rnyholm/iris/README.md

# Iris

Home for the simple marine auto pilot project Iris. This project should be seen as a fun, exploring, educational project. Involving anything from prototyping of electronics and coding to control engineering. 

### Goals

The goal with this project is to get a boat follow a given heading, this is done with a microcontroller taking input from a GPS(heading, ground speed, clock and so on), a rotary encoder for letting the user set the desired heading, a potentiometer joystick is used for letting the user override the autopilot. All the data is displayed on a 7 inch TFT screen. At last the microcontroller controls a linear servo attached to the rudder via a motorcontroller.  
A PID regulator is to be implemented on the microcontroller for calculating the controller ouput to the servo.
In short this is a kickass project with many interesting parts.

### Bits and pieces
[Arduino DUE](http://arduino.cc/en/Main/arduinoBoardDue)  
[Pololu JRK 12v12](http://www.pololu.com/product/1393)  
[Adafruit Ultimate GPS Breakout](http://www.adafruit.com/products/746)  
[LA-DW-12V 350N 250mm stroke](http://www.actuatorlinear.com/index.php?_m=mod_product&_a=view&p_id=238)  
[Rotary Encoder](https://www.sparkfun.com/products/10982)  
[7" color tft lcd with RA8875 controller board](http://www.buydisplay.com/default/7-inch-lcd-module-capacitive-touch-screen-panel-i2c-spi-serial)  
More is still to come...

### At last
Remember to support Open Source and Open Hardware communities!
