rnyholm/iris/src/iris/config/pololu_jrk_motor_controller.txt

INITIALIZED	0
INPUT_MODE	ANALOG
INPUT_MINIMUM	581
INPUT_MAXIMUM	2435
OUTPUT_MINIMUM	0
OUTPUT_NEUTRAL	2048
OUTPUT_MAXIMUM	4095
INPUT_INVERT	0
INPUT_SCALING_DEGREE	0
INPUT_POWER_WITH_AUX	0
INPUT_ANALOG_SAMPLES_EXPONENT	5
INPUT_DISCONNECT_MINIMUM	290
INPUT_DISCONNECT_MAXIMUM	3265
INPUT_NEUTRAL_MAXIMUM	1507
INPUT_NEUTRAL_MINIMUM	1507
SERIAL_MODE	USB_DUAL_PORT
SERIAL_FIXED_BAUD_RATE	9600
SERIAL_TIMEOUT	0
SERIAL_ENABLE_CRC	0
SERIAL_NEVER_SUSPEND	0
SERIAL_DEVICE_NUMBER	11
FEEDBACK_MODE	ANALOG
FEEDBACK_MINIMUM	1700
FEEDBACK_MAXIMUM	2330
FEEDBACK_INVERT	0
FEEDBACK_POWER_WITH_AUX	1
FEEDBACK_DEAD_ZONE	0
FEEDBACK_ANALOG_SAMPLES_EXPONENT	5
FEEDBACK_DISCONNECT_MINIMUM	1694
FEEDBACK_DISCONNECT_MAXIMUM	2336
PROPORTIONAL_MULTIPLIER	7
PROPORTIONAL_EXPONENT	0
INTEGRAL_MULTIPLIER	655
INTEGRAL_EXPONENT	10
DERIVATIVE_MULTIPLIER	1
DERIVATIVE_EXPONENT	0
PID_PERIOD	10
PID_INTEGRAL_LIMIT	1000
PID_RESET_INTEGRAL	0
MOTOR_PWM_FREQUENCY	0
MOTOR_INVERT	1
MOTOR_MAX_DUTY_CYCLE_WHILE_FEEDBACK_OUT_OF_RANGE	150
MOTOR_MAX_ACCELERATION_FORWARD	600
MOTOR_MAX_ACCELERATION_REVERSE	600
MOTOR_MAX_DUTY_CYCLE_FORWARD	150
MOTOR_MAX_DUTY_CYCLE_REVERSE	150
MOTOR_MAX_CURRENT_FORWARD	28
MOTOR_MAX_CURRENT_REVERSE	28
MOTOR_CURRENT_CALIBRATION_FORWARD	149
MOTOR_CURRENT_CALIBRATION_REVERSE	149
MOTOR_BRAKE_DURATION_FORWARD	0
MOTOR_BRAKE_DURATION_REVERSE	0
MOTOR_COAST_WHEN_OFF	0
ERROR_ENABLE	102
ERROR_LATCH	102
