rnyholm/iris/documentation/la_dw_specification.pdf

### Specification

MODEL | LA-DW
Input Voltage | 12VDC,24VDC,36VDC
Load capacity | 900N / 200Ibs
Stroke length | 1 inch- 12 inch/ 25mm- 300mm
Speed Range | 0.2 inch- 1.2 inch/sec / 5mm/ 30mm/sec
Duty Cycle | 25%
Operation Temperation | -25 °c - 65°c
Limit Switch | Factory Preset(not movable)
Potentiometer | 1Kom/ 5Kom/ 10Kom
IP grade | IP54, IP 65.

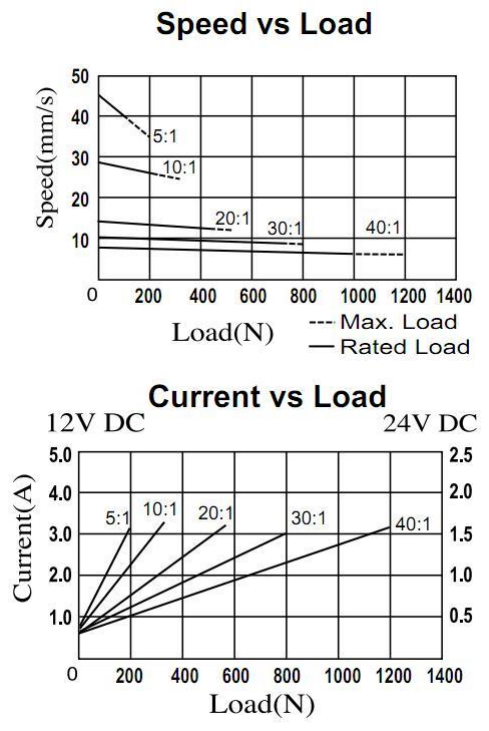
[picture p1: figure]

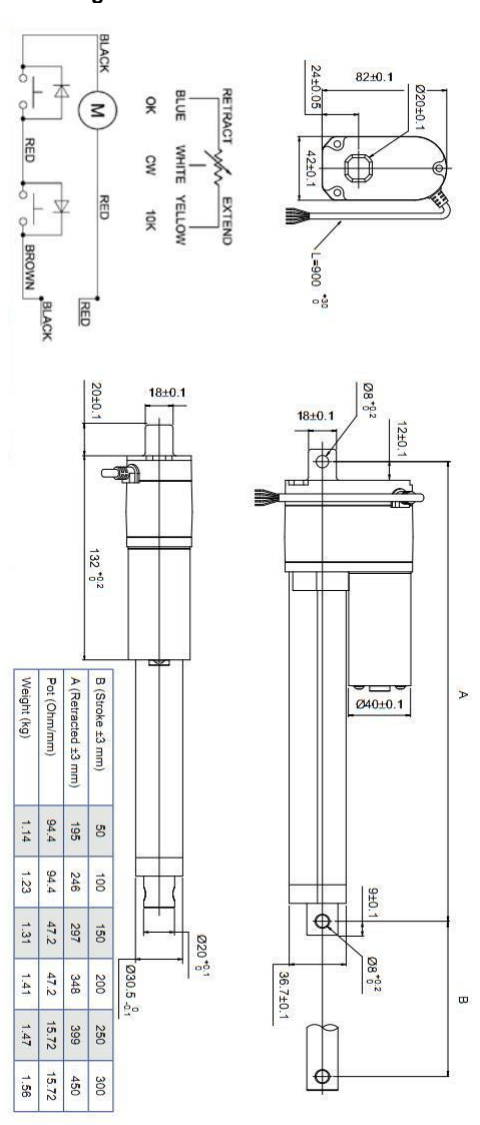
[picture p2: figure]

### Drawing
