rnyholm/iris/design/front_panel.png

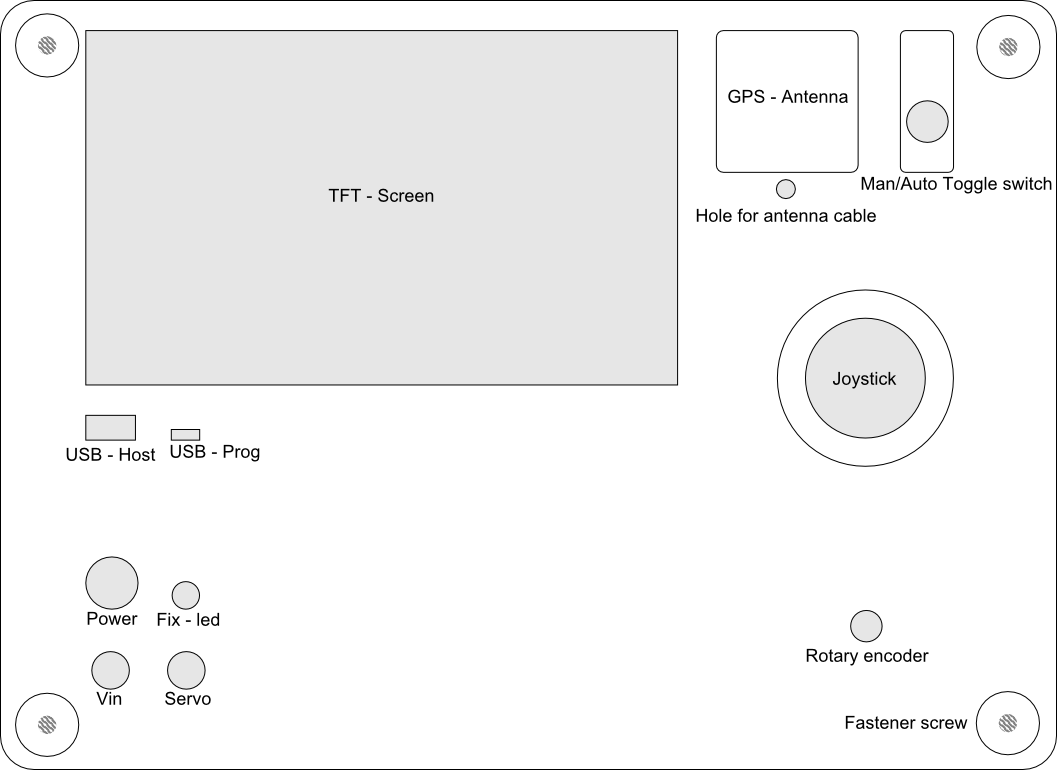
design/front_panel.png
