rnyholm/iris/eagle/iris/protshield.png

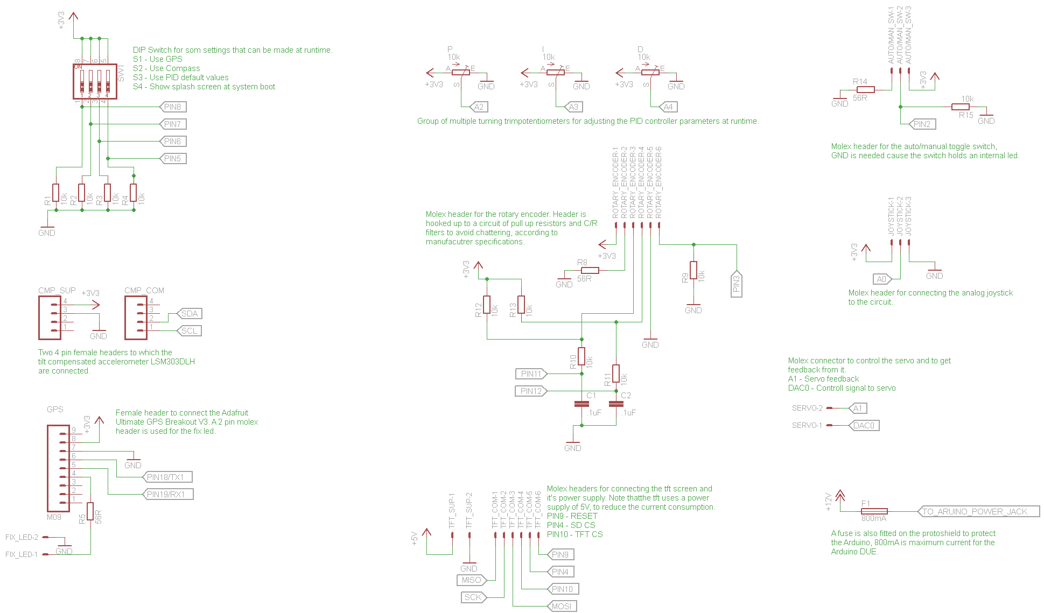
eagle/iris/protshield.png
