rnyholm/iris/eagle/iris/protoshield.sch

## EAGLE design eagle/iris/protoshield.sch (2014-07-16)

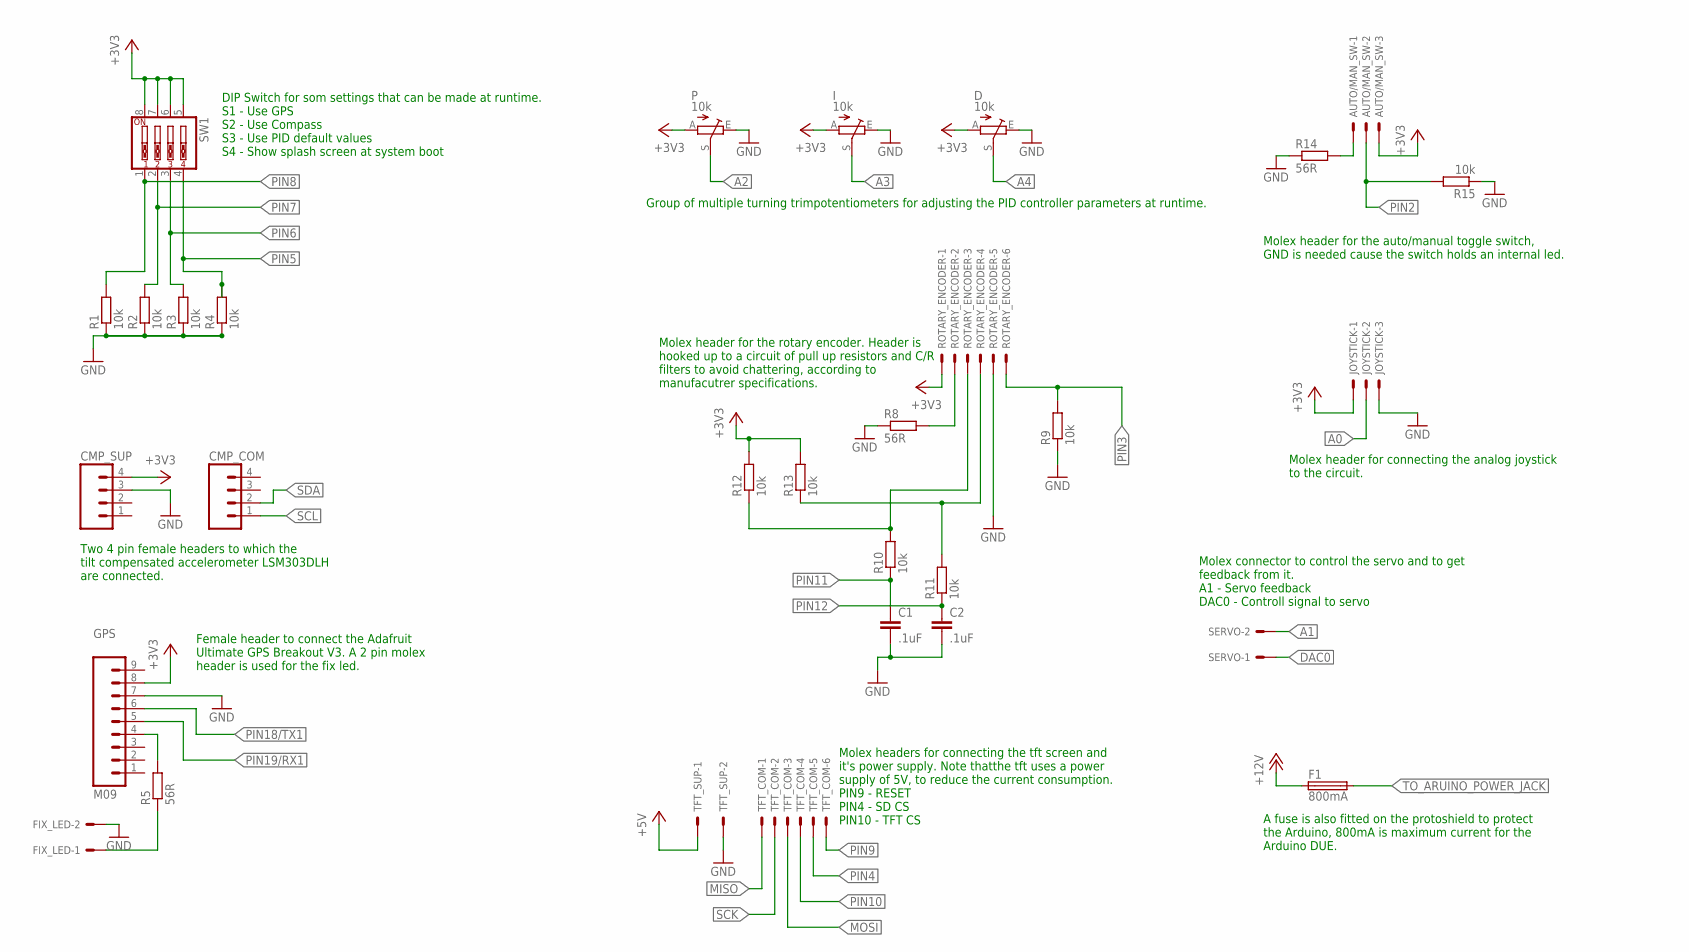
[picture p5: schematic protoshield.sch]

Parts:
AUTO/MAN_SW: KK-156-3
C1, C2: .1uF; C025-024X044
CMP_COM: M04PTH; 1X04
CMP_SUP: M04PTH; 1X04
D: 10k; S64W
F1: 800mA; SH22,5
FIX_LED: KK-156-2
GPS: M09; 1X09
I: 10k; S64W
JOYSTICK: KK-156-3
P: 10k; S64W
R1, R2, R3, R4, R9, R10, R11, R12, R13, R15: 10k; 0204/7
R5, R8, R14: 56R; 0204/7
ROTARY_ENCODER: KK-156-6
SERVO: KK-156-2
SW1: SW_DIP-4; EDG-04
TFT_COM: KK-156-6
TFT_SUP: KK-156-2

Connections:
+3V3: AUTO/MAN_SW.3, CMP_SUP.4, D.A, GPS.8, I.A, JOYSTICK.1, P.A, R12.2, R13.2, ROTARY_ENCODER.1, SW1.5, SW1.6, SW1.7, SW1.8
+5V: TFT_SUP.1
+12V: F1.1
A0: JOYSTICK.2
A1: SERVO.2
A2: P.S
A3: I.S
A4: D.S
DAC0: SERVO.1
GND: C1.2, C2.2, CMP_SUP.3, D.E, FIX_LED.2, GPS.7, I.E, JOYSTICK.3, P.E, R1.1, R2.1, R3.1, R4.1, R8.1, R9.1, R14.1, R15.1, ROTARY_ENCODER.5, TFT_SUP.2
MISO: TFT_COM.1
MOSI: TFT_COM.3
unnamed: AUTO/MAN_SW.1, R14.2
unnamed: R8.2, ROTARY_ENCODER.2
unnamed: GPS.4, R5.2
unnamed: R11.2, R13.1, ROTARY_ENCODER.4
unnamed: R10.2, R12.1, ROTARY_ENCODER.3
unnamed: FIX_LED.1, R5.1
PIN2: AUTO/MAN_SW.2, R15.2
PIN3: R9.2, ROTARY_ENCODER.6
PIN4: TFT_COM.5
PIN5: R4.2, SW1.4
PIN6: R3.2, SW1.3
PIN7: R2.2, SW1.2
PIN8: R1.2, SW1.1
PIN9: TFT_COM.6
PIN10: TFT_COM.4
PIN11: C1.1, R10.1
PIN12: C2.1, R11.1
PIN18/TX1: GPS.6
PIN19/RX1: GPS.5
SCK: TFT_COM.2
SCL: CMP_COM.1
SDA: CMP_COM.2
TO_ARUINO_POWER_JACK: F1.2

Notes on the sheet:
DIP Switch for som settings that can be made at runtime. S1 - Use GPS S2 - Use Compass S3 - Use PID default values S4 - Show splash screen at system boot
Group of multiple turning trimpotentiometers for adjusting the PID controller parameters at runtime.
Two 4 pin female headers to which the tilt compensated accelerometer LSM303DLH are connected.
Molex header for the rotary encoder. Header is hooked up to a circuit of pull up resistors and C/R filters to avoid chattering, according to manufacutrer specifications.
Molex header for the auto/manual toggle switch, GND is needed cause the switch holds an internal led.
Molex header for connecting the analog joystick to the circuit.
Female header to connect the Adafruit Ultimate GPS Breakout V3. A 2 pin molex header is used for the fix led.
Molex headers for connecting the tft screen and it's power supply. Note thatthe tft uses a power supply of 5V, to reduce the current consumption. PIN9 - RESET PIN4 - SD CS PIN10 - TFT CS
Molex connector to control the servo and to get feedback from it. A1 - Servo feedback DAC0 - Controll signal to servo
A fuse is also fitted on the protoshield to protect the Arduino, 800mA is maximum current for the Arduino DUE.
