rnyholm/iris/laborations/tft7Inch/RA8875-bd53a9e165a1/Arial12x12.h

#ifndef ARIAL12X12_H
#define ARIAL12X12_H

//GLCD FontName : Arial12x12
//GLCD FontSize : 12 x 12

/** Arial Font with 12*12 matrix to use with SPI_TFT lib */
//__align(2)

const unsigned char Arial12x12[] = {
    25,12,12,2,                   // Bytes/char, horz, vert, byte/vert
    //width, pixel stream ....
    0x07, 0X00, 0X00, 0X00, 0X00, 0X00, 0X00, 0X00, 0X00, 0X00, 0X00, 0X00, 0X00, 0X00, 0X00, 0X00, 0X00, 0X00, 0X00, 0X00, 0X00, 0X00, 0X00, 0X00, 0X00,  // Code for char
    0x02, 0X00, 0X00, 0x7F, 0x01, 0X00, 0X00, 0X00, 0X00, 0X00, 0X00, 0X00, 0X00, 0X00, 0X00, 0X00, 0X00, 0X00, 0X00, 0X00, 0X00, 0X00, 0X00, 0X00, 0X00,  // Code for char !
    0x03, 0x07, 0X00, 0X00, 0X00, 0x07, 0X00, 0X00, 0X00, 0X00, 0X00, 0X00, 0X00, 0X00, 0X00, 0X00, 0X00, 0X00, 0X00, 0X00, 0X00, 0X00, 0X00, 0X00, 0X00,  // Code for char "
    0x07, 0x24, 0X00, 0xA4, 0x01, 0x7C, 0X00, 0xA7, 0x01, 0x7C, 0X00, 0x27, 0X00, 0x24, 0X00, 0X00, 0X00, 0X00, 0X00, 0X00, 0X00, 0X00, 0X00, 0X00, 0X00,  // Code for char #
    0x06, 0X00, 0X00, 0xCE, 0X00, 0x11, 0x01, 0xFF, 0x03, 0x11, 0x01, 0xE2, 0X00, 0X00, 0X00, 0X00, 0X00, 0X00, 0X00, 0X00, 0X00, 0X00, 0X00, 0X00, 0X00,  // Code for char $
    0x0A, 0X00, 0X00, 0x0E, 0X00, 0x11, 0X00, 0x11, 0x01, 0xCE, 0X00, 0x38, 0X00, 0xE6, 0X00, 0x11, 0x01, 0x10, 0x01, 0xE0, 0X00, 0X00, 0X00, 0X00, 0X00,  // Code for char %
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
    0x08, 0X00, 0X00, 0xFE, 0x01, 0x02, 0x01, 0x02, 0x01, 0x02, 0x01, 0x02, 0x01, 0x02, 0x01, 0xFE, 0x01, 0X00, 0X00, 0X00, 0X00, 0X00, 0X00, 0X00, 0X00   // Code for char <del>
};

#endif // ARIAL12X12_H
