rnyholm/iris/laborations/tft7Inch/RA8875-bd53a9e165a1/Small_6.h

#ifndef SMALL_6_H
#define SMALL_6_H

const unsigned char Small_6[] = {
    9,8,8,1,                                    // Length,horz,vert,byte/vert
    0x05, 0x00, 0x00, 0x00, 0x00, 0x00, 0x00, 0x00, 0x00,  // Code for char  
    0x02, 0x00, 0x2F, 0x00, 0x00, 0x00, 0x00, 0x00, 0x00,  // Code for char !
    0x04, 0x00, 0x03, 0x00, 0x03, 0x00, 0x00, 0x00, 0x00,  // Code for char "
    0x06, 0x00, 0x12, 0x3F, 0x12, 0x3F, 0x12, 0x00, 0x00,  // Code for char #
    0x04, 0x00, 0x26, 0x7F, 0x32, 0x00, 0x00, 0x00, 0x00,  // Code for char $
    0x05, 0x00, 0x13, 0x0B, 0x34, 0x32, 0x00, 0x00, 0x00,  // Code for char %
    0x05, 0x00, 0x1A, 0x25, 0x1A, 0x28, 0x00, 0x00, 0x00,  // Code for char &
    0x02, 0x00, 0x03, 0x00, 0x00, 0x00, 0x00, 0x00, 0x00,  // Code for char '
    0x03, 0x00, 0x7E, 0x81, 0x00, 0x00, 0x00, 0x00, 0x00,  // Code for char (
    0x03, 0x00, 0x81, 0x7E, 0x00, 0x00, 0x00, 0x00, 0x00,  // Code for char )
    0x03, 0x00, 0x03, 0x03, 0x00, 0x00, 0x00, 0x00, 0x00,  // Code for char *
    0x04, 0x00, 0x08, 0x1C, 0x08, 0x00, 0x00, 0x00, 0x00,  // Code for char +
    0x02, 0x00, 0x60, 0x00, 0x00, 0x00, 0x00, 0x00, 0x00,  // Code for char ,
    0x03, 0x00, 0x08, 0x08, 0x00, 0x00, 0x00, 0x00, 0x00,  // Code for char -
    0x02, 0x00, 0x20, 0x00, 0x00, 0x00, 0x00, 0x00, 0x00,  // Code for char .
    0x03, 0x00, 0x38, 0x07, 0x00, 0x00, 0x00, 0x00, 0x00,  // Code for char /
    0x05, 0x00, 0x1E, 0x21, 0x21, 0x1E, 0x00, 0x00, 0x00,  // Code for char 0
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
    0x03, 0x00, 0x77, 0x08, 0x00, 0x00, 0x00, 0x00, 0x00,  // Code for char }
    0x04, 0x02, 0x01, 0x02, 0x01, 0x00, 0x00, 0x00, 0x00,  // Code for char ~
    0x02, 0x00, 0x3F, 0x00, 0x00, 0x00, 0x00, 0x00, 0x00   // Code for char 
    };

#endif // SMALL_6_H
