rnyholm/iris/laborations/tft7Inch/demo_compleet/demo_compleet.ino

//#include <DueTimer.h>

#include <SPI.h>
#include <Adafruit_GFX.h>
#include <Adafruit_RA8875.h>
#include <Wire.h>
#include <FT5x06.h>

// Library only supports hardware SPI at this time
// Connect SCLK to UNO Digital #13 (Hardware SPI clock)
// Connect MISO to UNO Digital #12 (Hardware SPI MISO)
// Connect MOSI to UNO Digital #11 (Hardware SPI MOSI)
#define RA8875_INT 3
#define CTP_INT           2
#define RA8875_CS 10
#define RA8875_RESET 9
//#define Show_String(X,Y) tft.textWrite(X)


//   **************************************************************************************************************************************************
//                          Pas Pic Library benamingen aan naar Arduino
//   **************************************************************************************************************************************************

#define LCD_DataWrite tft.writeData
#define LCD_CmdWrite tft.writeCommand
#define uchar byte 
#define LCD_DataRead tft.readData
#define bit boolean
#define LCD_StatusRead tft.readStatus
#define Delay1ms(X) delay(1*X)
#define Delay10ms(X) delay(10*X)

#define Delay100ms(X) delay(100*X)
#define ulong long



bit touch_flag = 0;//if touching = 1
bit button_Font_flag = 0; //
bit button_Draw_flag = 0;
bit	button_Touch_flag = 0;
bit	button_BTE_flag = 0;
bit	button_DMA_flag = 0;
bit	button_PWM_flag = 0;
//bit	button_Cursor_flag = 0;
bit button_Clear_flag = 0;
bit button_Exit_flag = 0;
bit button_Exit2_flag = 0;

bit minus_button_flag = 0;
bit plus_button_flag = 0;

bit touch_levle2_flag = 0;
uint LCD_X1,LCD_Y1,LCD_X2,LCD_Y2,LCD_X3,LCD_Y3,LCD_X4,LCD_Y4,LCD_X5,LCD_Y5;

#define	cSetD0		     0x01
#define	cSetD1		     0x02
#define	cSetD2		     0x04
#define	cSetD3		     0x08
#define	cSetD4		     0x10
#define	cSetD5		     0x20
#define	cSetD6		     0x40
#define	cSetD7		     0x80

#define	cClrD0		     0xfe
#define	cClrD1		     0xfd
#define	cClrD2		     0xfb
#define	cClrD3		     0xf7
#define	cClrD4		     0xef
#define	cClrD5		     0xdf
#define	cClrD6		     0xbf
#define	cClrD7		     0x7f

#define cClrD1D0         0xfc
#define cClrD1SetD0	     0x01
#define cSetD1ClrD0	     0x02
#define cSetD1D0		 0x03
#define cClrD3D2         0xf3
#define cClrD3SetD2      0x04
#define cSetD3ClrD2      0x08
#define cSetD3D2		 0x0c

#define cClrD2D1D0		 0xf8
#define cClrD2D1SetD0	 0x01
#define cClrD2SetD1ClrD0 0x02
#define cClrD2SetD1D0	 0x03
#define cSetD2ClrD1D0	 0x04
#define cSetD2ClrD1SetD0 0x05

#define cClrD6D5D4	     0x8f
#define cClrD6D5SetD4    0x10
#define cClrD6SetD5ClrD4 0x20
#define cClrD6SetD5D4	 0x30
#define cSetD6ClrD5D4	 0x40
#define cSetD6ClrD5SetD4 0x50
#define cSetD6D5ClrD4	 0x60
#define cSetD6D5D4		 0x70
#define Color65k

#define color_black   0x0000
#define color_white   0xffff
#define color_red     0xf800
#define color_green   0x07e0
#define color_blue    0x001f
#define color_yellow  color_red|color_green
#define color_cyan    color_green|color_blue
#define color_purple  color_red|color_blue
#define color_grayscale1    2113
#define color_grayscale2    2113*2
#define color_grayscale3    2113*3
#define color_grayscale4    2113*4
#define color_grayscale5    2113*5
#define color_grayscale6    2113*6
#define color_grayscale7    2113*7
#define color_grayscale8    2113*8
#define color_grayscale9    2113*9
#define color_grayscale10   2113*10
#define color_grayscale11   2113*11
#define color_grayscale12   2113*12
#define color_grayscale13   2113*13
#define color_grayscale14   2113*14
#define color_grayscale15   2113*15
#define color_grayscale16   2113*16
#define color_grayscale17   2113*17
#define color_grayscale18   2113*18
#define color_grayscale19   2113*19
#define color_grayscale20   2113*20
#define color_grayscale21   2113*21
#define color_grayscale22   2113*22
#define color_grayscale23   2113*23
#define color_grayscale24   2113*24
#define color_grayscale25   2113*25
#define color_grayscale26   2113*26
#define color_grayscale27   2113*27
#define color_grayscale28   2113*28
#define color_grayscale29   2113*29
#define color_grayscale30   2113*30


byte nr_of_touches = 0;
Adafruit_RA8875 tft = Adafruit_RA8875(RA8875_CS, RA8875_RESET);
uint16_t tx, ty;
FT5x06 cmt = FT5x06(CTP_INT);
  word coordinates[10];
void myHandler(){
	WDT_Restart( WDT );
 byte registers[FT5206_NUMBER_OF_REGISTERS];




  byte prev_nr_of_touches = 0;

  if (cmt.touched()) {
    Serial.println("cmt.touched");
    cmt.getRegisterInfo(registers);
    nr_of_touches = cmt.getTouchPositions(coordinates, registers);
    Serial.print("nr_of_touches ");
    Serial.println(nr_of_touches);
    prev_nr_of_touches = nr_of_touches;
    Get_ALL_XY();
    confirm_button_touch();
  }
}

void setup() {
  Serial.begin(115200);
  Serial.println("RA8875 start");
  /* Initialise the display using 'RA8875_800x480' */
  if (!tft.begin(RA8875_800x480)) {
    Serial.println("RA8875 Not Found!");
    while (1);
  }
  Serial.println("Found RA8875");
Timer3.attachInterrupt(myHandler);
	Timer3.start(50000); // Calls every 50ms

  tft.GPIOX(true);      // Enable TFT - display enable tied to GPIOX
  tft.PWM1config(true, RA8875_PWM_CLK_DIV1024); // PWM output for backlight
  tft.PWM1out(255);

  
uint8_t	P0 = 0xff;
uint8_t	P1 = 0xff;
uint8_t	P2 = 0xff;
uint8_t	P3 = 0xff;
uint8_t	AUXR = 0x22;  
uint8_t	STRETCH = 0x01;

  
  pinMode(RA8875_INT, INPUT);
  digitalWrite(RA8875_INT, HIGH);

  cmt.init(false);
  
  Active_Window(0,799,0,479);
  Clear_Active_Window();
  
  Text_Foreground_Color(0x00,0x00,0x00);
  Text_Background_Color(0x00,0x00,0xff);
  Memory_Clear();	
  tft.displayOn(true);

	PWM1_enable();
    PWM1_fnuction_sel();
    PWM1_clock_ratio(0x0a); //bit0~3     for 3.5"TFT  ra8870_demo_v3
    PWM1_duty_cycle(0xff);
    
    



	//---------------------------//
    //*******set Font rom*******
	CGROM_Font();
	//CGRAM_Font();

	//Internal_CGROM();
    External_CGROM();


    //Font_size_16x16_8x16(); 
    Font_size_24x24_12x24();
    //Font_size_32x32_16x32();
    
    //GT_serial_ROM_select_GT21L16T1W();
	//GT_serial_ROM_select_GT23L16U2W();
	//  GT_serial_ROM_select_GT23L24T3Y();
	//GT_serial_ROM_select_GT23L24M1Z();
	GT_serial_ROM_select_GT23L32S4W();

    //Font_code_GB2312();
    //Font_code_GB12345();
    Font_code_BIG5();
    //Font_code_UNICODE();
    //Font_code_ASCII();
    //Font_code_UNIJIS();
    //Font_code_JIS0208();
     //Font_code_LATIN();


    //Font_Standard();
    //Font_Arial();
    Font_Roman();
    //Font_Bold();
     
    Serial_ROM_select0();
    //Serial_ROM_select1();
	Serial_ROM_Address_set_24bit();
    //Serial_ROM_Address_set_32bit();
    //Select_Serial_Waveform_mode0();
    Select_Serial_Waveform_mode3();

    //SERIAL_ROM_Read_Cycle_4bus();
    SERIAL_ROM_Read_Cycle_5bus();
    //SERIAL_ROM_Read_Cycle_6bus();

	SERIAL_ROM_Font_mode();
    //SERIAL_ROM_DMA_mode();

    SERIAL_ROM_Signal_mode();
    //SERIAL_ROM_Dual_mode0();
    //SERIAL_ROM_Dual_mode1();

	//*************************
    SROM_CLK_DIV(0x02);
   

	//*****write grapic cursor******

    Write_To_Bank1();
    
     Font_with_BackgroundTransparency();

	button_Font(0);
	button_Draw(0);
	button_Touch(0);
	button_BTE(0);
	button_DMA(0);
	button_PWM(0);
	Show_first_page();   
   


 
    
}

void loop() 
{
				 
	while(button_Font_flag)
	{

	 Show_button_Font_function();

	 button_Font_flag = 0;
	}

	while(button_Draw_flag)
	{

	 Show_button_Draw_function();

	 button_Draw_flag = 0;
	}

	while(button_Touch_flag)
	{
	 Show_button_Touch_function();
	 button_Touch_flag = 0;
	}

	while(button_BTE_flag)
	{
	 Show_button_BTE_function();
	 button_BTE_flag = 0;
	}

	while(button_DMA_flag)
	{
	 Show_button_DMA_function();

	 button_DMA_flag = 0;
	}

	while(button_PWM_flag)
	{
	  Show_button_PWM_function();

	 button_PWM_flag = 0;
	}
}



char gImage_p16x16[512] = { /* 0X10,0X10,0X00,0X10,0X00,0X10,0X01,0X1B, */
0X00,0X01,0X10,0X83,0X00,0X00,0X00,0X41,0X00,0X22,0X00,0X23,0XE7,0XFF,0X74,0X95,
0XA5,0XFA,0XEF,0XFF,0X00,0X23,0X00,0X43,0X00,0X00,0X08,0X01,0X00,0X01,0X00,0X01,
0X00,0X01,0X00,0X01,0XFF,0XFF,0XEF,0XBF,0X00,0XC5,0X00,0X43,0XDF,0XFF,0X5B,0XD2,
0X8D,0X37,0XE7,0XFF,0X00,0X43,0X00,0X63,0XEF,0X9F,0X08,0X63,0X00,0X01,0X00,0X01,
0X00,0X00,0XFF,0XFF,0X9D,0X78,0X95,0X58,0XEF,0XDF,0X00,0X02,0XD7,0X9F,0X53,0XB1,
0X7C,0XF6,0XEF,0XFF,0X00,0X02,0XDF,0X3F,0X84,0X95,0XB5,0XFA,0XFF,0XFF,0X00,0X00,
0X00,0X00,0XEF,0XDF,0XBE,0X5C,0X5B,0X71,0X9D,0X38,0XF7,0XFF,0XEF,0XFF,0X43,0X30,
0X8D,0X38,0XDF,0XBF,0XEF,0XDF,0X7B,0XF3,0X29,0XCB,0XB6,0X1B,0XFF,0XFF,0X00,0X20,
0X00,0XE0,0X00,0X40,0XF7,0XFF,0XB6,0X1C,0X53,0X53,0X9D,0X9D,0XDF,0X7F,0X84,0X96,
0X9D,0X7A,0XDF,0X7F,0X6B,0XF7,0X3A,0X90,0XCE,0X9E,0XFF,0XFF,0X00,0X20,0X00,0X40,
0X00,0X60,0X00,0X40,0X08,0XA4,0XEF,0XDF,0XBE,0X9F,0X4B,0X34,0XEF,0XFF,0XE7,0X9F,
0XF7,0XFF,0XC6,0XBE,0X3A,0X91,0XB6,0X5F,0XF7,0XBF,0X00,0X02,0X00,0X60,0X00,0XA0,
0XEF,0XFF,0XD7,0X5F,0XD7,0X5F,0XEF,0XFF,0XE7,0X9F,0XF7,0XFF,0XE7,0XBE,0X00,0XE1,
0X00,0X40,0XF7,0XFF,0XF7,0XFF,0XCE,0XDF,0XEF,0XBF,0XEF,0XBF,0XDF,0X5F,0XEF,0XFF,
0X8D,0X17,0X74,0X76,0X6C,0X39,0X6B,0XF8,0X8C,0XD9,0XF7,0XFF,0X00,0XA0,0X00,0X60,
0X00,0XE0,0X00,0X40,0XCE,0XBD,0X5B,0X12,0X3A,0X32,0X42,0XB3,0X3A,0X6E,0XAD,0XFA,
0XC6,0XFE,0XA5,0XFC,0XA5,0XDF,0XA5,0XDF,0XAD,0XDD,0XEF,0XDF,0X00,0XA0,0X00,0X60,
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
0X5B,0X6D,0X6B,0XCF,0X7C,0X72,0X84,0XD3,0X7C,0X93,0X74,0X31,0X6B,0XF1,0X6B,0XF1,
0X74,0X52,0X74,0X53,0X6C,0X52,0X6C,0X11,0X6C,0X12,0X64,0X12,0X5B,0XD1,0X4B,0X4F,
0X4B,0X4F,0X4B,0X4F,0X43,0X0F,0X3A,0XEE,0X43,0X0F,0X4B,0X50,0X4B,0X70,0X43,0X4F,
};
