rnyholm/iris/(commit log)

2014-05-12 Added schematics for DUE
2014-05-13 Added documentation for linear actuator
2014-05-27 Added libraries for driving servo and getting it's feedback, also made a little demo program driving servo from minimum to maximum position
2014-06-14 Added method for a nice startup screen, also make it sd-missing safe
    [iris.ino]
2014-07-16 Added schematics of the protoshield
    [protoshield.sch]
2014-08-04 #6 Cursor doesn't flicker anymore when showing splashscreen
    [iris.ino]
2014-08-06 #7 Possible to choose if splashscreen should be shown on startup or not by using a DIP switch, if switch number 4 is set HIGH than splashscreen will be shown
2014-08-06 #7 Possible to choose if gps should be used as a navigation source or not by using a DIP switch, if switch number 1 is set HIGH than gps will be used
2014-08-08 #1 Laborations with rotary encoder
2014-08-08 #1 Progress on encoder implementation
2014-08-11 #9 Attached interrupt and added ISR for setting desired course
